HeyImK/smol32/Images/prpl.png

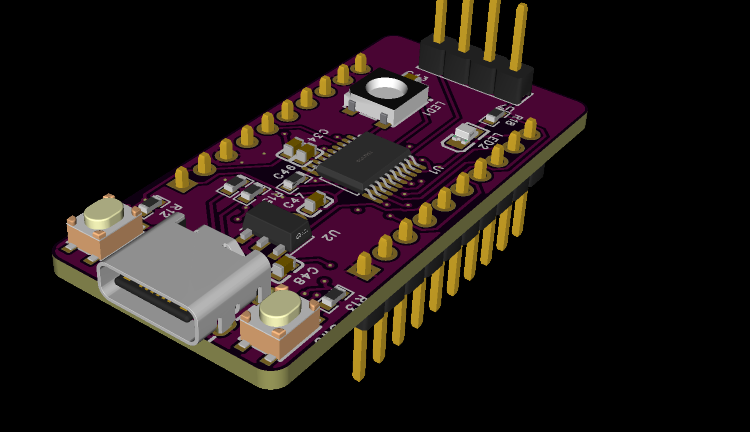
Images/prpl.png
