HeyImK/smol32/Images/silk screen.png

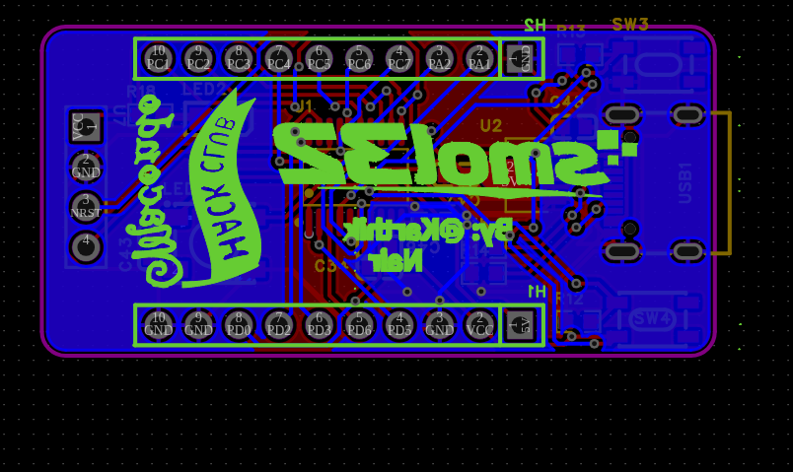
Images/silk screen.png
