HeyImK/smol32/schematics-smol32.pdf

# TYPE-C PORT

# MCU CONNECTIONS

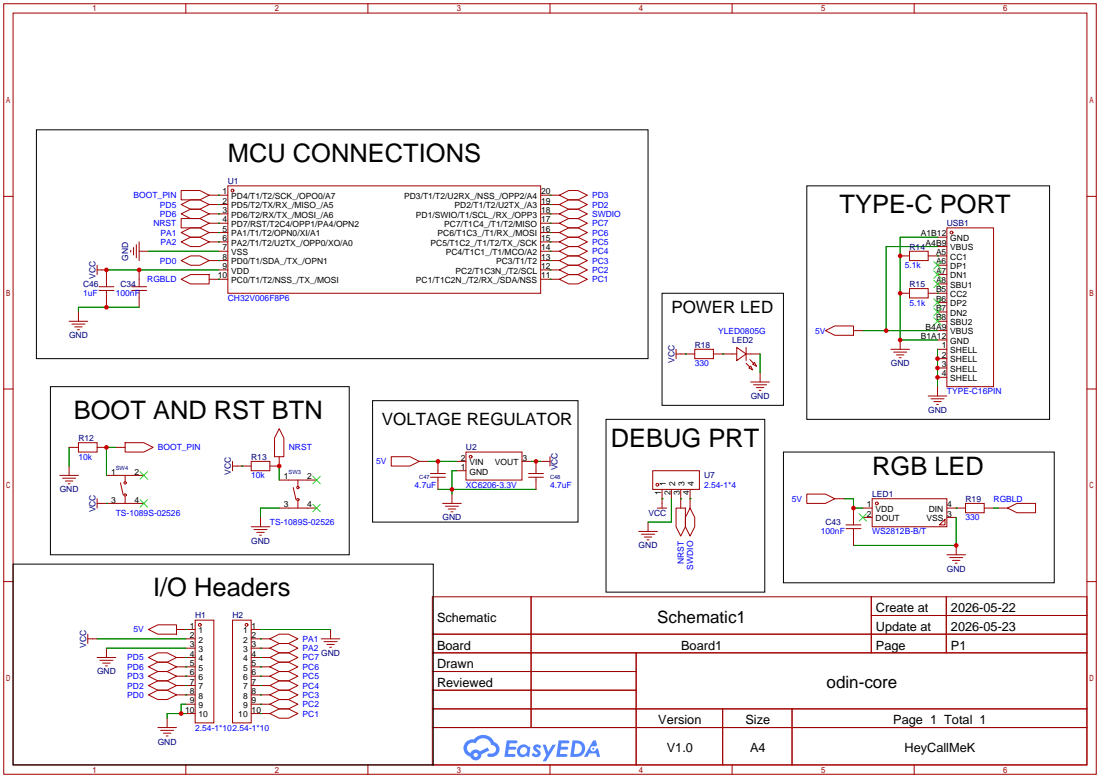
[picture p8: page 1]

Schematic | Schematic1 | Create at | 2026-05-22

Update at | 2026-05-23

Board | Board1 | Page | P1
Drawn | | odin-core
Reviewed

Version | Size | Page 1 Total 1
V1.0 | A4 | HeyCallMeK
