HeyImK/smol32/(list of files, drawings)

Other design files:
SRC/smol32src.epro
