HeyImK/smol32/(commit log)

2026-05-25 added
    Updated the README to reflect the new board name and features.
2026-05-25 Update PCB routing section in README
2026-05-25 Simplify pin descriptions in README
    Removed unnecessary details from pin descriptions in the README.
2026-06-05 Revise README
    Removed PCB stackup and routing strategy details, along with ordering and manufacturing instructions from the README.
